med-yassine-ben-salah/ros2-diffdrive-robot-fusion360-cad/robot/previews/front.png

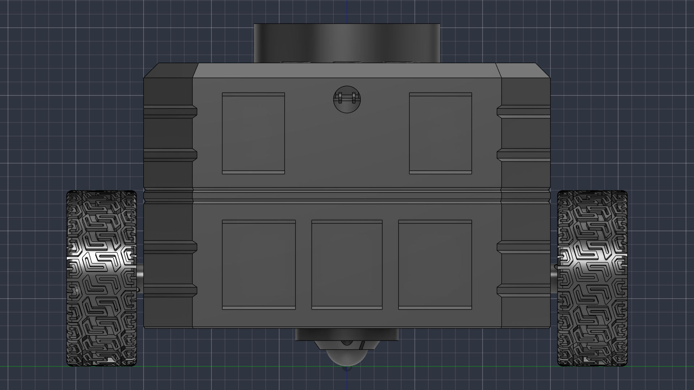
robot/previews/front.png
