med-yassine-ben-salah/ros2-diffdrive-robot-fusion360-cad/robot/previews/left.png

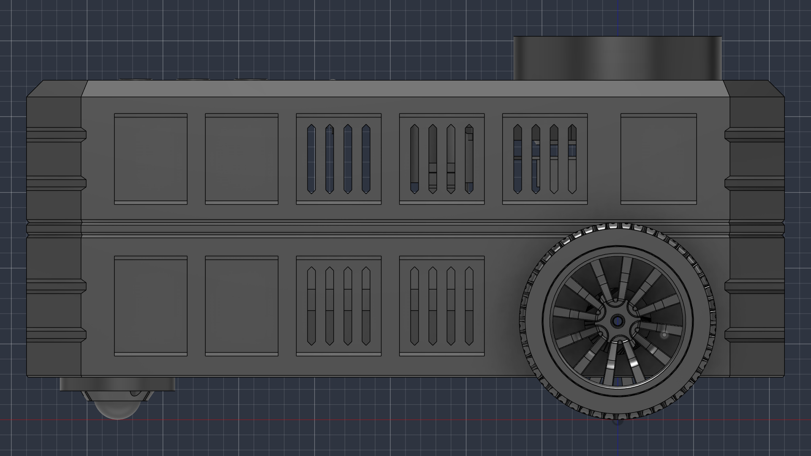
robot/previews/left.png
