med-yassine-ben-salah/ros2-diffdrive-robot-fusion360-cad/robot/previews/rear.png

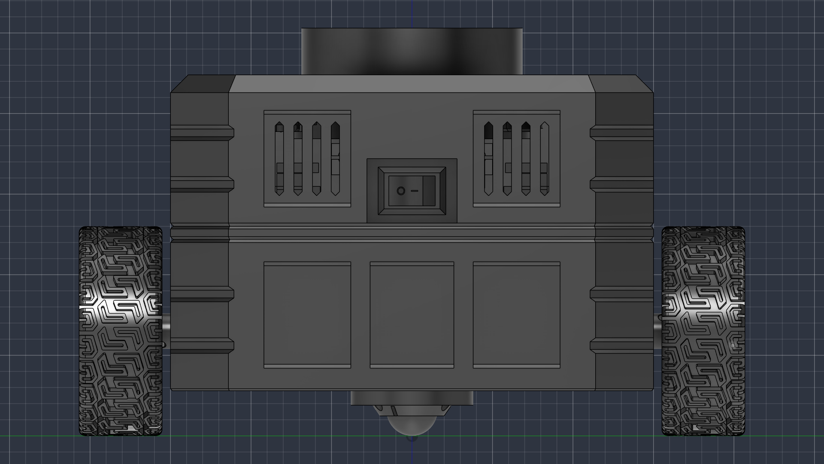
robot/previews/rear.png
