med-yassine-ben-salah/ros2-diffdrive-robot-fusion360-cad/robot/previews/right.png

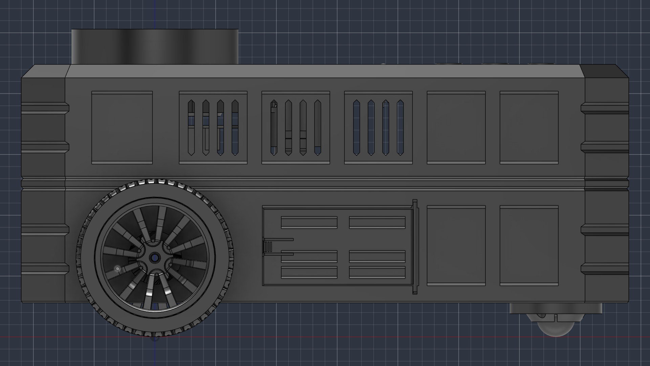
robot/previews/right.png
