med-yassine-ben-salah/ros2-diffdrive-robot-fusion360-cad/models/JGA25-371_with_encoder_ASM.STL

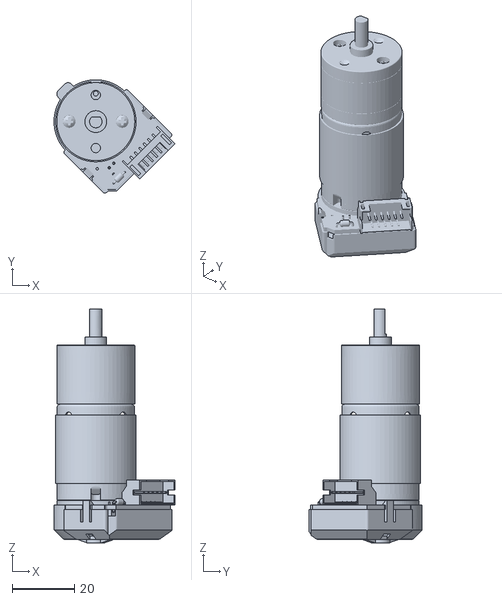
[picture p9: CAD file, 2026-10-25]
models/JGA25-371_with_encoder_ASM.STL
38.8 x 36.3 x 75.0
