med-yassine-ben-salah/ros2-diffdrive-robot-fusion360-cad/robot/export/Upper_Enclosure.step

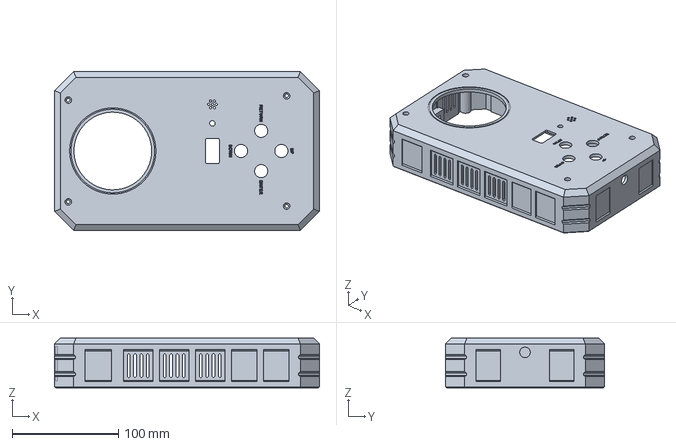
[picture p10: CAD file, 2026-10-25]
robot/export/Upper_Enclosure.step
250.0 x 150.0 x 47.0 mm
