med-yassine-ben-salah/ros2-diffdrive-robot-fusion360-cad/ros2_diffdrive_description/meshes/battery_door.stl

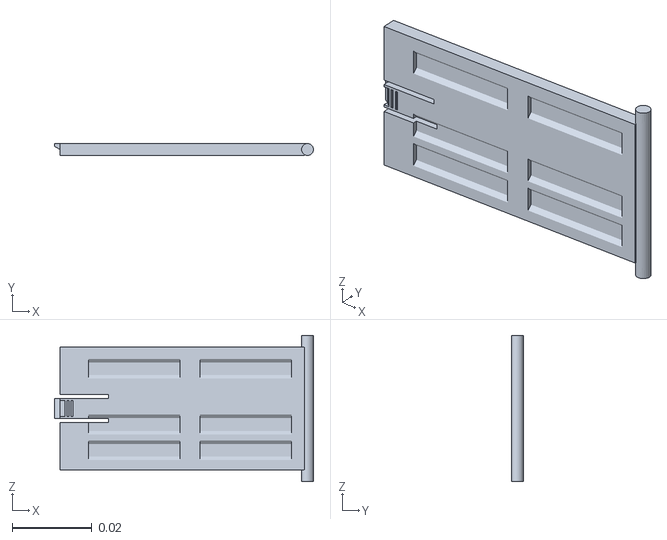
[picture p11: CAD file, 2026-10-25]
ros2_diffdrive_description/meshes/battery_door.stl
0.0651 x 0.003 x 0.0368
