med-yassine-ben-salah/ros2-diffdrive-robot-fusion360-cad/models/lds02rr.step

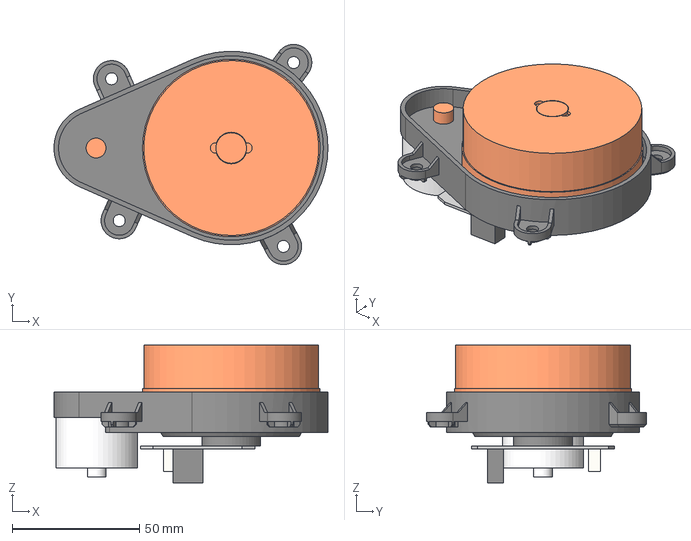
[picture p12: CAD file, 2026-10-25]
models/lds02rr.step
107.6 x 86.5 x 54.1 mm
