med-yassine-ben-salah/ros2-diffdrive-robot-fusion360-cad/ros2_diffdrive_description/meshes/right_wheel.stl

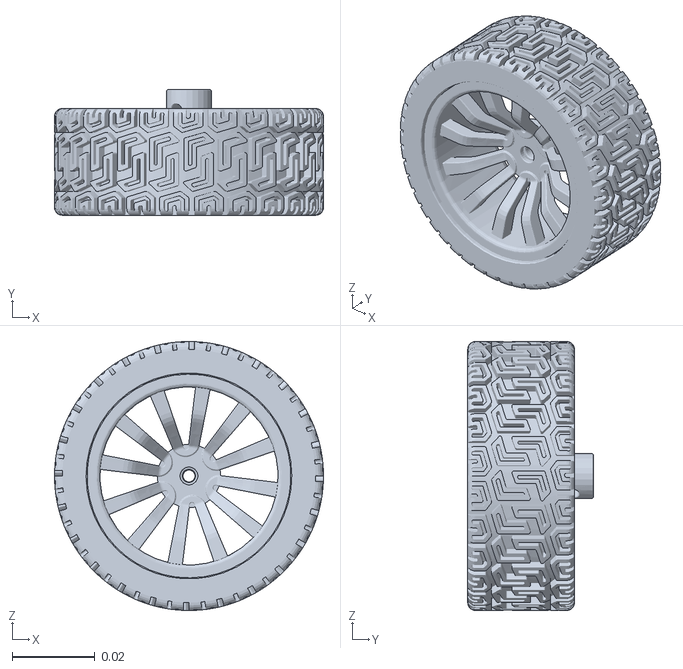
[picture p13: CAD file, 2026-10-25]
ros2_diffdrive_description/meshes/right_wheel.stl
0.0649 x 0.0303 x 0.0649
