med-yassine-ben-salah/ros2-diffdrive-robot-fusion360-cad/models/esp32cam_with_MB.stl

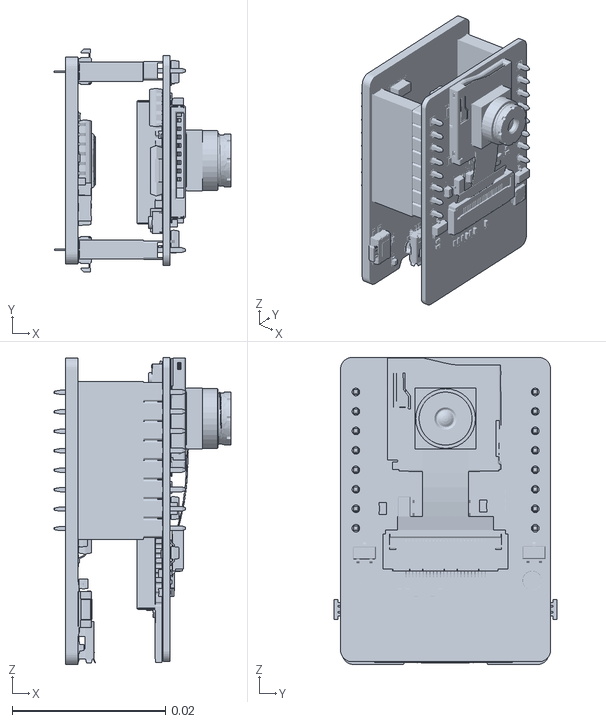
[picture p14: CAD file, 2026-10-25]
models/esp32cam_with_MB.stl
0.023 x 0.0291 x 0.0401
