med-yassine-ben-salah/ros2-diffdrive-robot-fusion360-cad/robot/export/Caster_Socket_Housing.step

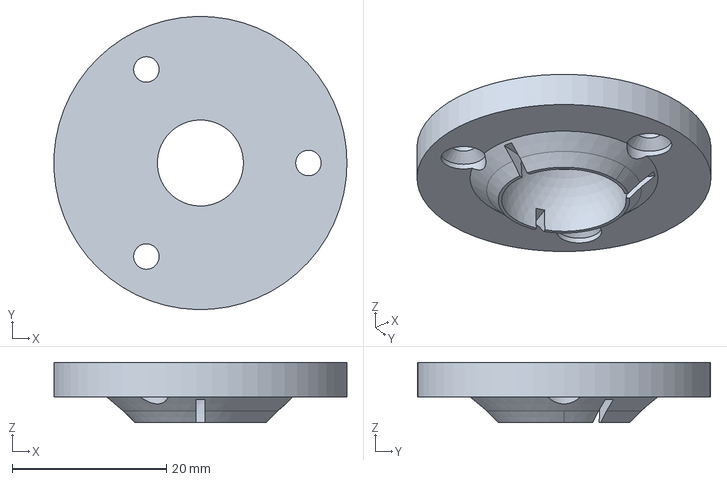
[picture p15: CAD file, 2026-10-25]
robot/export/Caster_Socket_Housing.step
38.0 x 38.0 x 7.80 mm
