med-yassine-ben-salah/ros2-diffdrive-robot-fusion360-cad/ros2_diffdrive_description/meshes/right_motor.stl

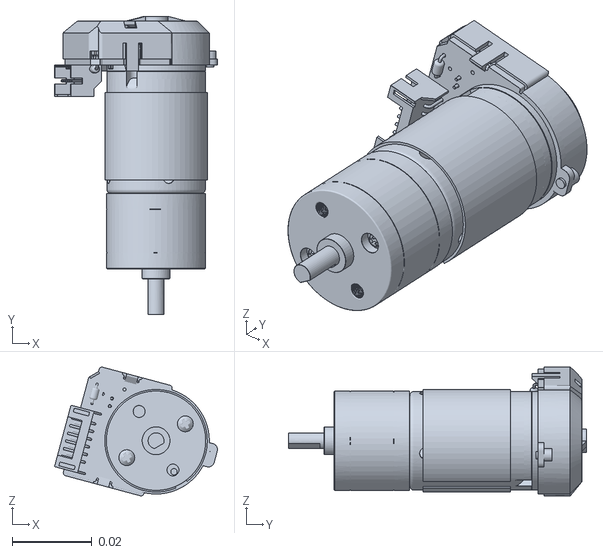
[picture p16: CAD file, 2026-10-25]
ros2_diffdrive_description/meshes/right_motor.stl
0.041 x 0.075 x 0.0324
