med-yassine-ben-salah/ros2-diffdrive-robot-fusion360-cad/models/JGA25-371_Wheel__65mm.STEP

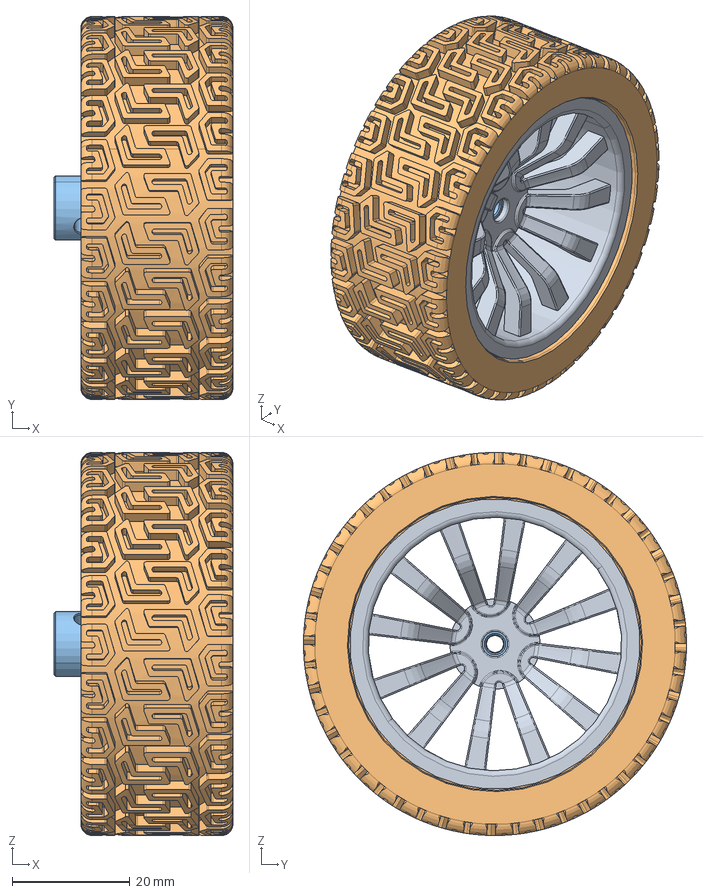
[picture p17: CAD file, 2026-10-25]
models/JGA25-371_Wheel__65mm.STEP
30.3 x 64.9 x 64.9 mm
