med-yassine-ben-salah/ros2-diffdrive-robot-fusion360-cad/robot/export/Battery_Door.step

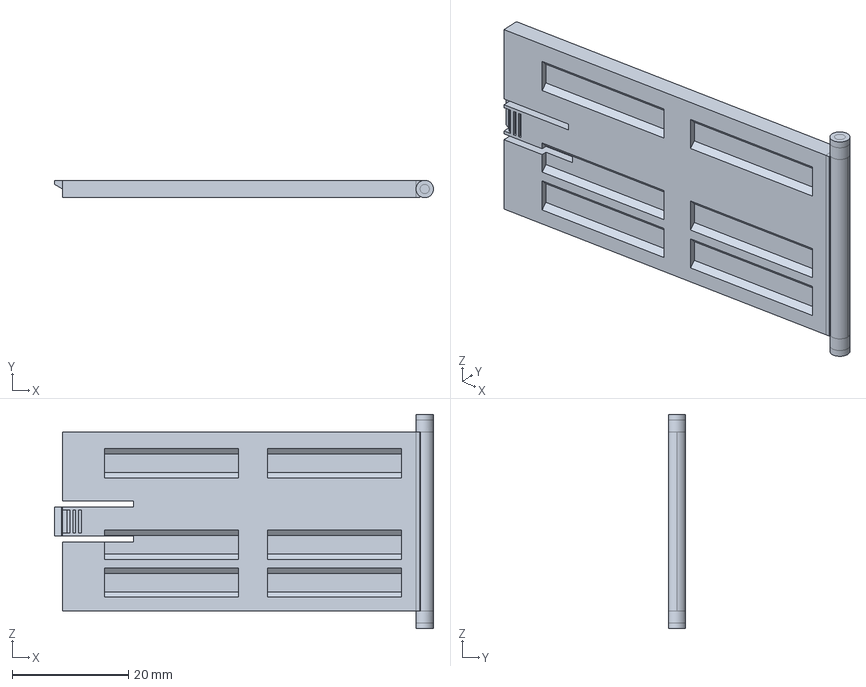
[picture p18: CAD file, 2026-10-25]
robot/export/Battery_Door.step
65.1 x 3.00 x 36.8 mm
