med-yassine-ben-salah/ros2-diffdrive-robot-fusion360-cad/ros2_diffdrive_description/meshes/ui_switches_caps.stl

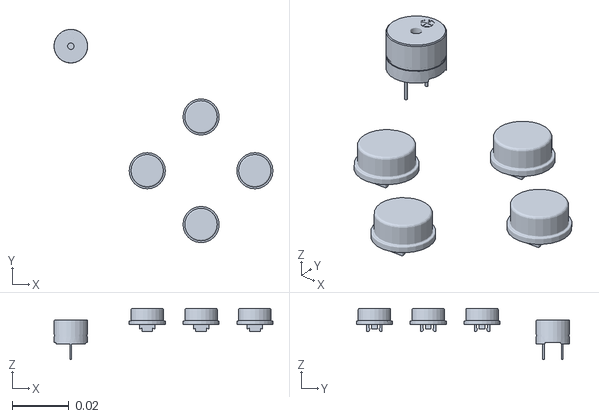
[picture p19: CAD file, 2026-10-25]
ros2_diffdrive_description/meshes/ui_switches_caps.stl
0.0773 x 0.0753 x 0.0181
