med-yassine-ben-salah/ros2-diffdrive-robot-fusion360-cad/models/mpu9250_step.step

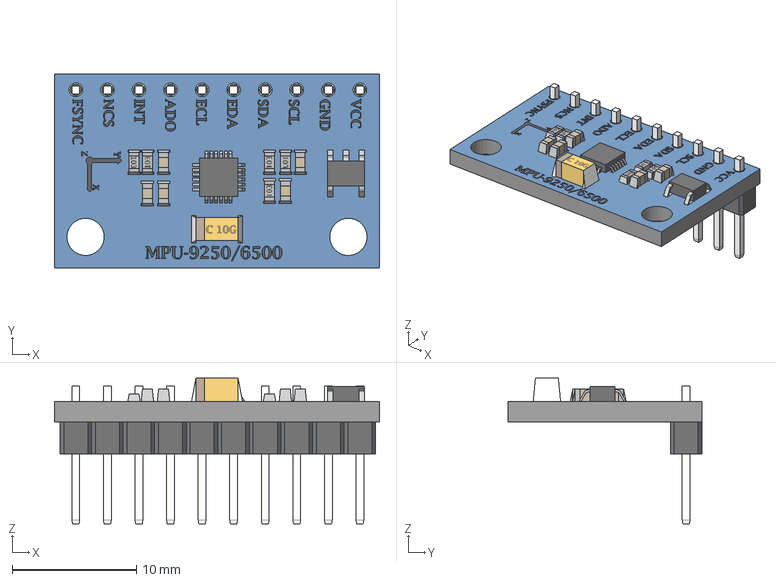
[picture p20: CAD file, 2026-10-25]
models/mpu9250_step.step
26.1 x 15.6 x 11.7 mm
