med-yassine-ben-salah/ros2-diffdrive-robot-fusion360-cad/robot/export/UI_Button_Carrier.step

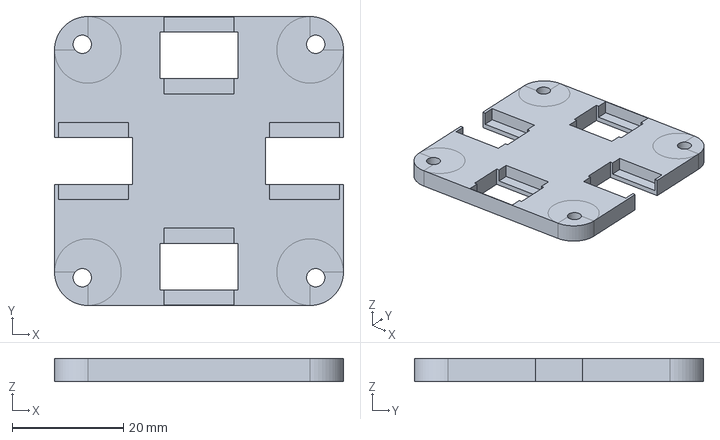
[picture p21: CAD file, 2026-10-25]
robot/export/UI_Button_Carrier.step
52.0 x 52.0 x 4.15 mm
