med-yassine-ben-salah/ros2-diffdrive-robot-fusion360-cad/ros2_diffdrive_description/meshes/ui_oled_switches.stl

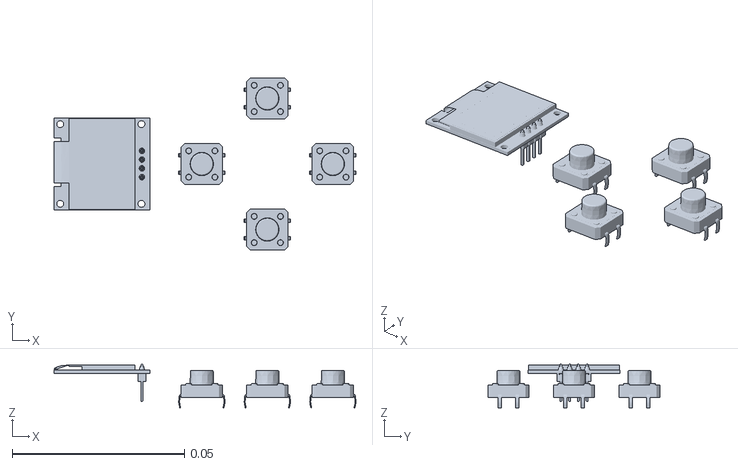
[picture p22: CAD file, 2026-10-25]
ros2_diffdrive_description/meshes/ui_oled_switches.stl
0.0876 x 0.05 x 0.0127
