med-yassine-ben-salah/ros2-diffdrive-robot-fusion360-cad/models/Passive_Buzzer.step

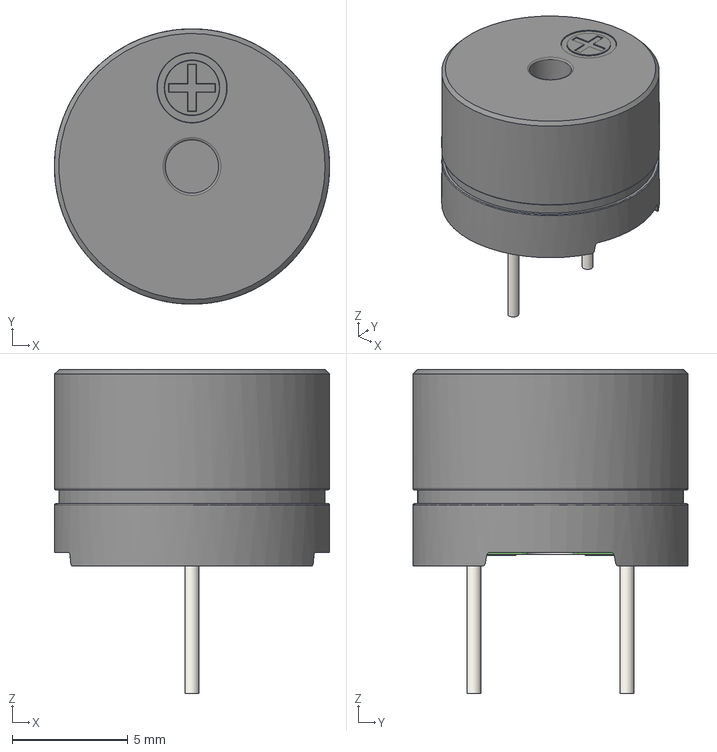
[picture p23: CAD file, 2026-10-25]
models/Passive_Buzzer.step
11.9 x 11.9 x 14.0 mm
