med-yassine-ben-salah/ros2-diffdrive-robot-fusion360-cad/robot/export/Electronics_Deck.step

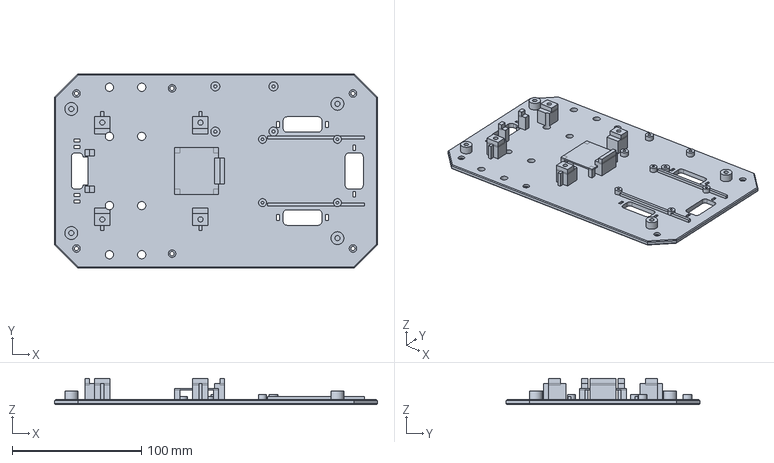
[picture p24: CAD file, 2026-10-25]
robot/export/Electronics_Deck.step
250.0 x 150.0 x 20.4 mm
