med-yassine-ben-salah/ros2-diffdrive-robot-fusion360-cad/models/ON_OFF_Switch.STEP

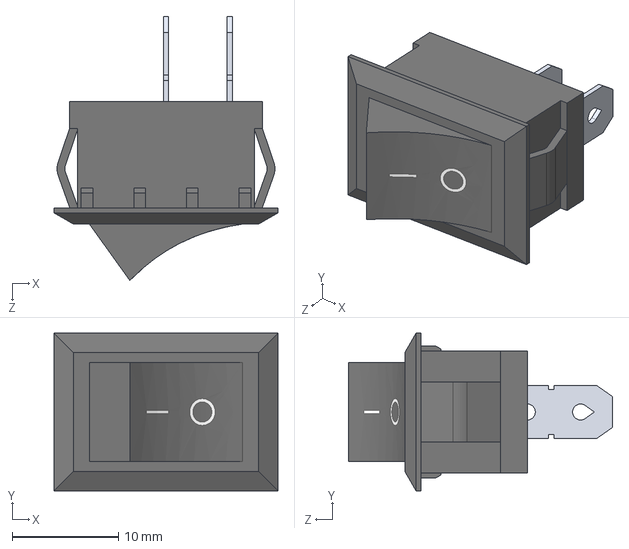
[picture p25: CAD file, 2026-10-25]
models/ON_OFF_Switch.STEP
21.0 x 14.8 x 24.8 mm
