med-yassine-ben-salah/ros2-diffdrive-robot-fusion360-cad/ros2_diffdrive_description/meshes/red_accents.stl

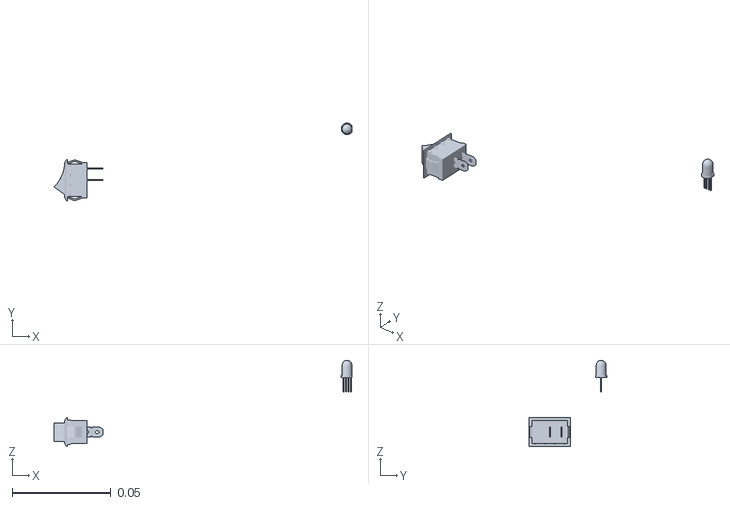
[picture p26: CAD file, 2026-10-25]
ros2_diffdrive_description/meshes/red_accents.stl
0.151 x 0.0395 x 0.0437
