med-yassine-ben-salah/ros2-diffdrive-robot-fusion360-cad/models/5mm_LED_RGB.stp

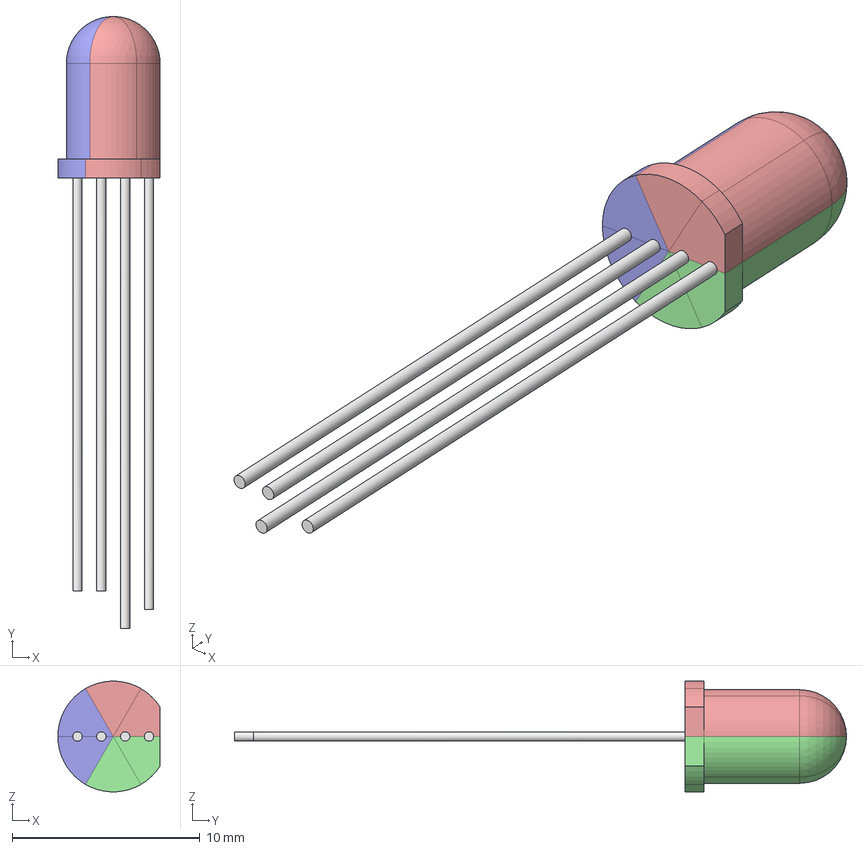
[picture p27: CAD file, 2026-10-25]
models/5mm_LED_RGB.stp
5.45 x 32.6 x 5.89 mm
