med-yassine-ben-salah/ros2-diffdrive-robot-fusion360-cad/robot/export/ESP32_CAM_Bracket.step

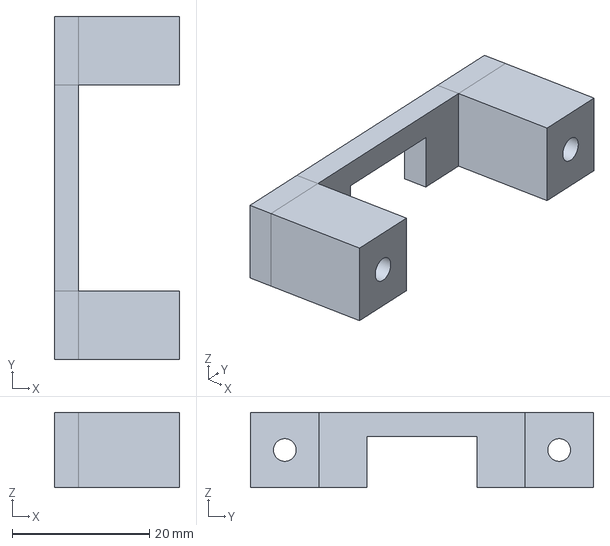
[picture p28: CAD file, 2026-10-25]
robot/export/ESP32_CAM_Bracket.step
18.2 x 50.0 x 11.0 mm
