med-yassine-ben-salah/ros2-diffdrive-robot-fusion360-cad/ros2_diffdrive_description/meshes/lds02rr_lidar.stl

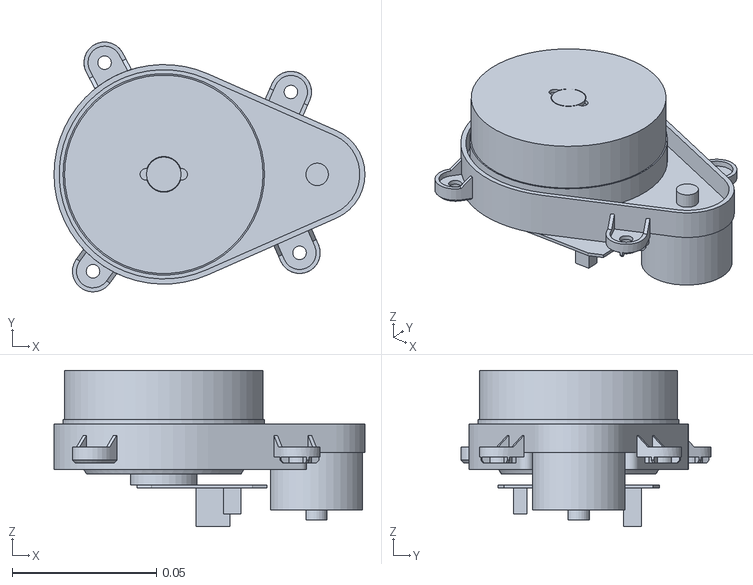
[picture p29: CAD file, 2026-10-25]
ros2_diffdrive_description/meshes/lds02rr_lidar.stl
0.108 x 0.0865 x 0.0541
