med-yassine-ben-salah/ros2-diffdrive-robot-fusion360-cad/models/JGA25-371_Bracket.stl

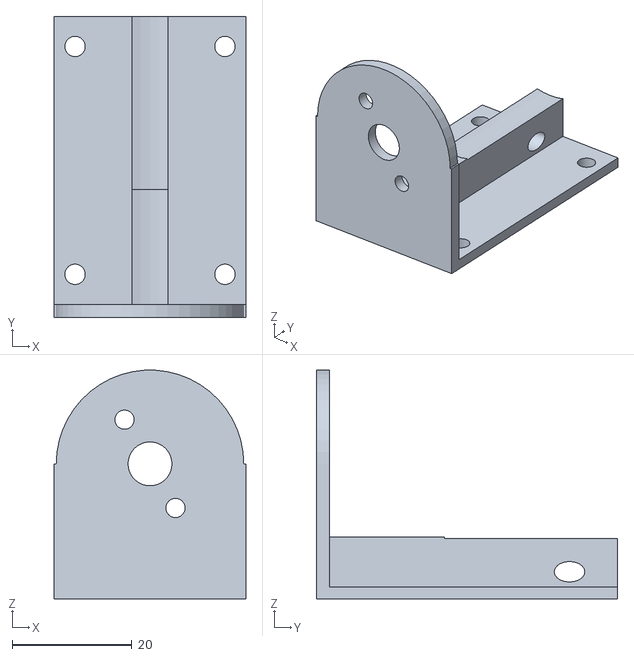
[picture p30: CAD file, 2026-10-25]
models/JGA25-371_Bracket.stl
32.0 x 50.2 x 38.1
