med-yassine-ben-salah/ros2-diffdrive-robot-fusion360-cad/robot/export/Lower_Chassis.step

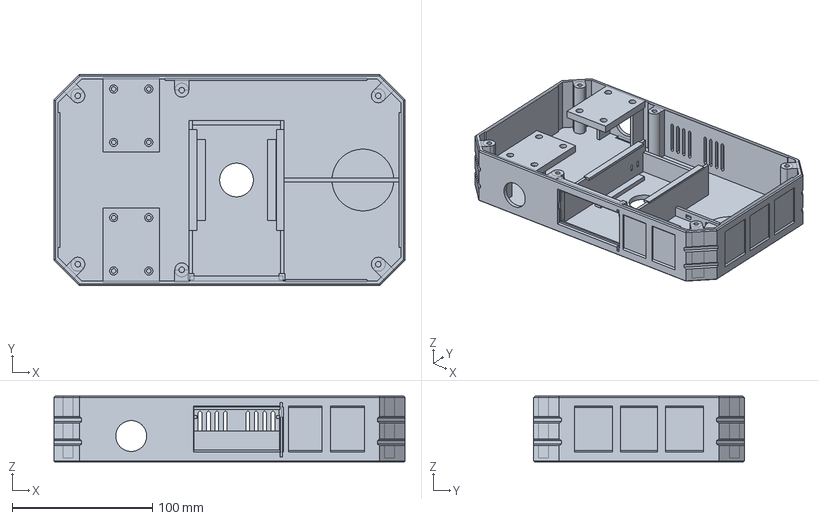
[picture p31: CAD file, 2026-10-25]
robot/export/Lower_Chassis.step
250.0 x 150.0 x 47.0 mm
