med-yassine-ben-salah/ros2-diffdrive-robot-fusion360-cad/ros2_diffdrive_description/meshes/electronics_deck.stl

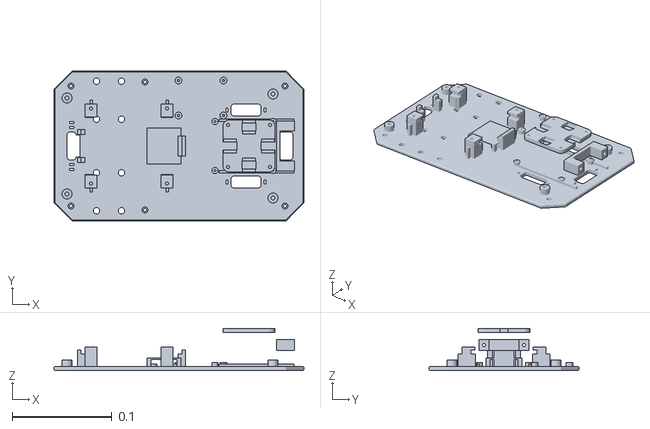
[picture p32: CAD file, 2026-10-25]
ros2_diffdrive_description/meshes/electronics_deck.stl
0.25 x 0.15 x 0.0422
