med-yassine-ben-salah/ros2-diffdrive-robot-fusion360-cad/models/switch_cap_black.stp

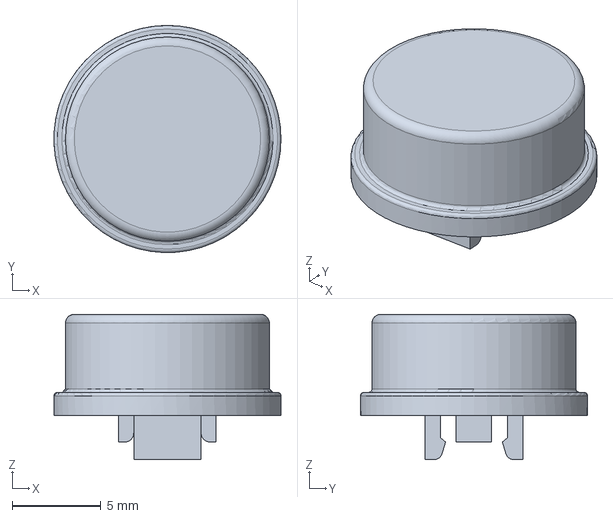
[picture p33: CAD file, 2026-10-25]
models/switch_cap_black.stp
12.8 x 12.8 x 8.20 mm
