med-yassine-ben-salah/ros2-diffdrive-robot-fusion360-cad/ros2_diffdrive_description/meshes/lower_chassis.stl

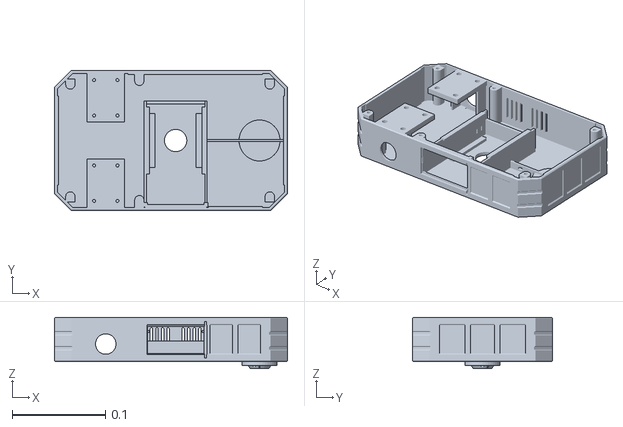
[picture p34: CAD file, 2026-10-25]
ros2_diffdrive_description/meshes/lower_chassis.stl
0.25 x 0.15 x 0.0548
