med-yassine-ben-salah/ros2-diffdrive-robot-fusion360-cad/models/LDS02RR_Plate.stl

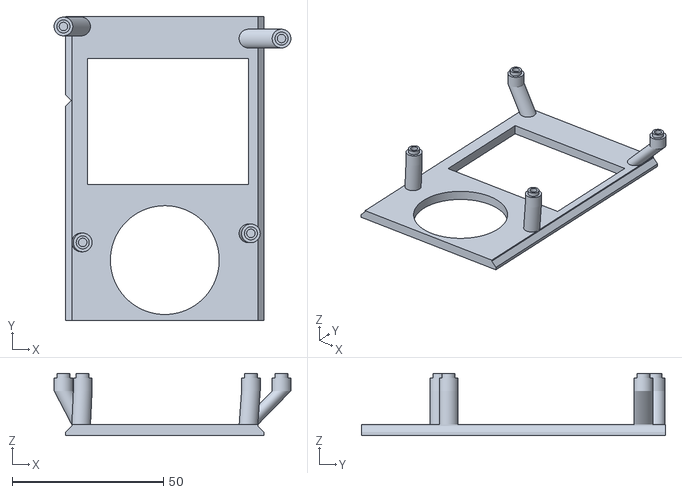
[picture p35: CAD file, 2026-10-25]
models/LDS02RR_Plate.stl
78.4 x 100.6 x 20.6
