med-yassine-ben-salah/ros2-diffdrive-robot-fusion360-cad/robot/export/LiDAR_Pillar_Clamps.step

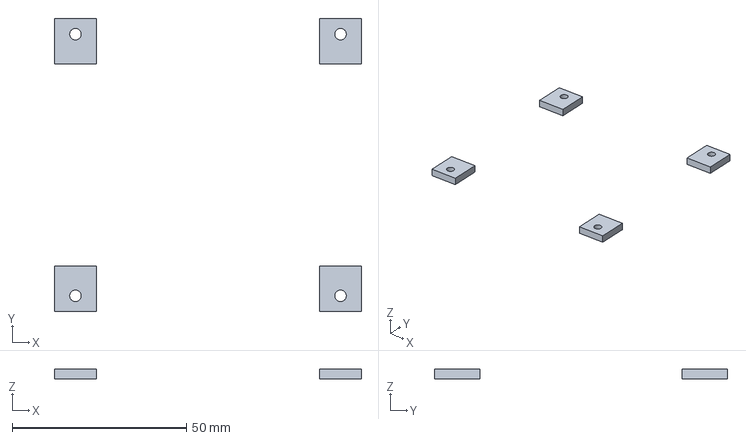
[picture p36: CAD file, 2026-10-25]
robot/export/LiDAR_Pillar_Clamps.step
88.0 x 84.0 x 3.00 mm
