med-yassine-ben-salah/ros2-diffdrive-robot-fusion360-cad/ros2_diffdrive_description/meshes/imu_mpu9250.stl

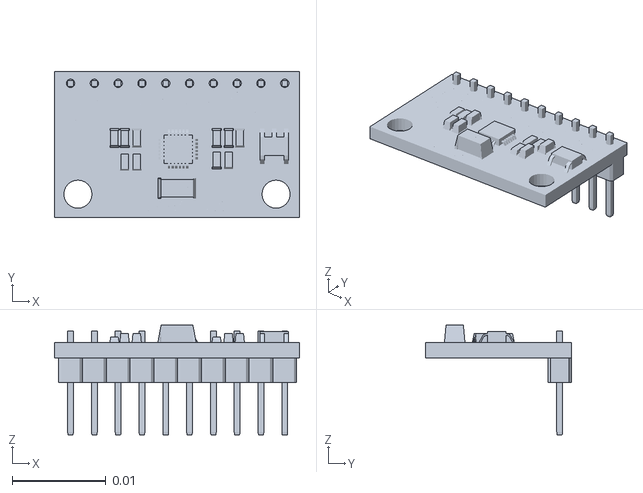
[picture p38: CAD file, 2026-10-25]
ros2_diffdrive_description/meshes/imu_mpu9250.stl
0.0261 x 0.0156 x 0.0117
