med-yassine-ben-salah/ros2-diffdrive-robot-fusion360-cad/ros2_diffdrive_description/meshes/drivetrain_static.stl

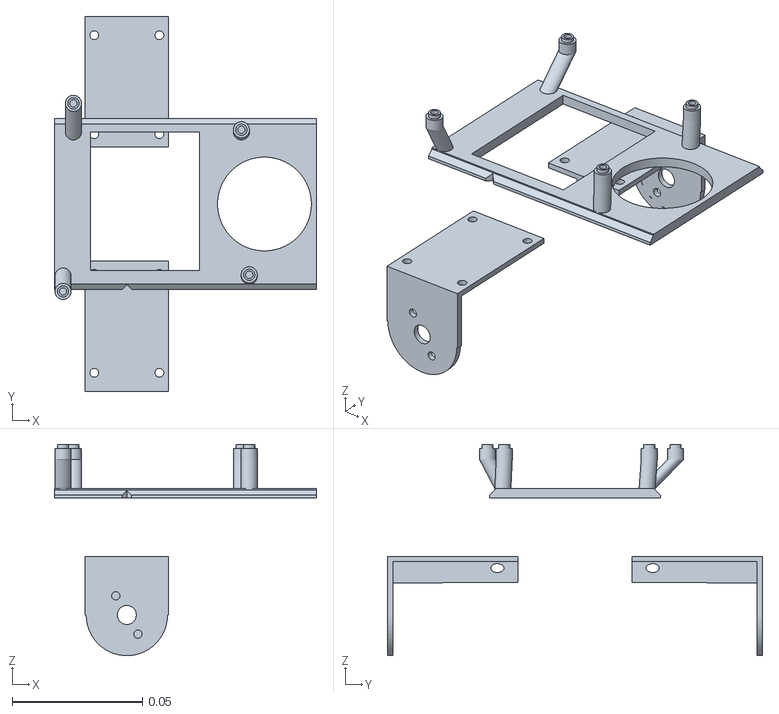
[picture p39: CAD file, 2026-10-25]
ros2_diffdrive_description/meshes/drivetrain_static.stl
0.101 x 0.144 x 0.0811
