med-yassine-ben-salah/ros2-diffdrive-robot-fusion360-cad/robot/export/LiDAR_Pillar_Clamp_Single.stl

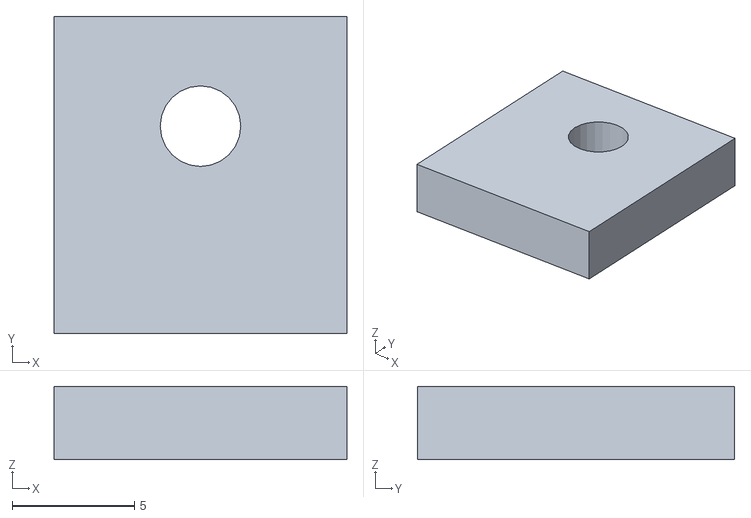
[picture p40: CAD file, 2026-10-25]
robot/export/LiDAR_Pillar_Clamp_Single.stl
12.0 x 13.0 x 3.00
