med-yassine-ben-salah/ros2-diffdrive-robot-fusion360-cad/ros2_diffdrive_description/meshes/caster_ball.stl

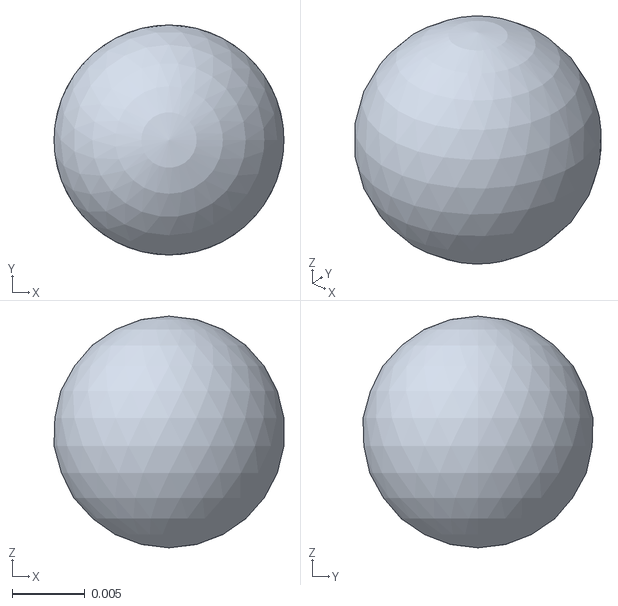
[picture p41: CAD file, 2026-10-25]
ros2_diffdrive_description/meshes/caster_ball.stl
0.0158 x 0.0158 x 0.0159
