med-yassine-ben-salah/ros2-diffdrive-robot-fusion360-cad/ros2_diffdrive_description/meshes/battery_pack.stl

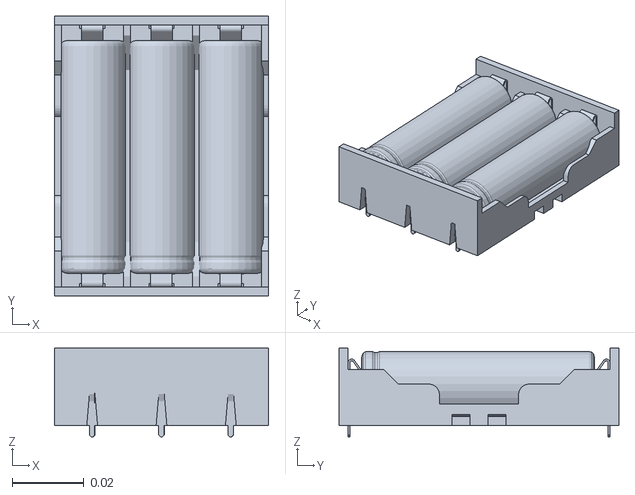
[picture p42: CAD file, 2026-10-25]
ros2_diffdrive_description/meshes/battery_pack.stl
0.0596 x 0.078 x 0.0247
