med-yassine-ben-salah/ros2-diffdrive-robot-fusion360-cad/robot/export/ROS2_DiffDrive_Robot.FCStd

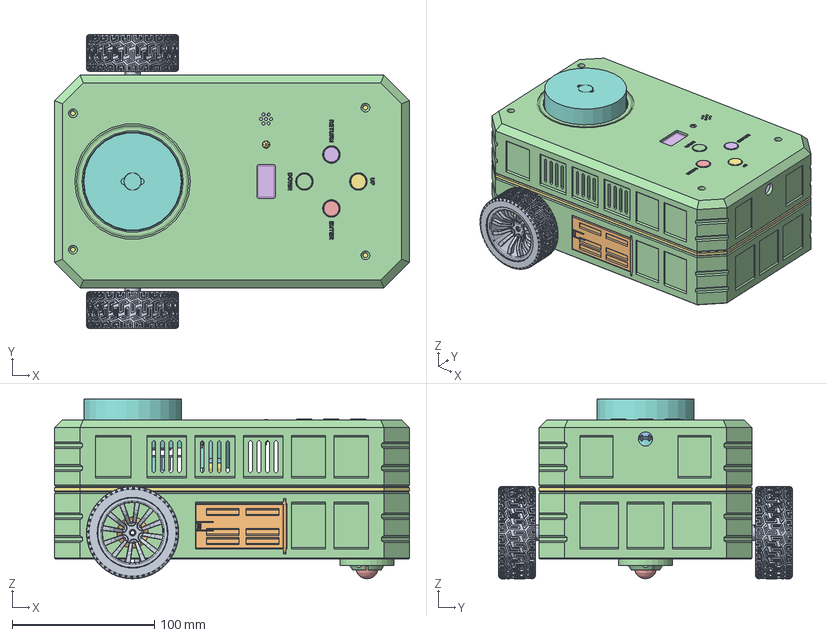
[picture p43: CAD file, 2026-10-25]
robot/export/ROS2_DiffDrive_Robot.FCStd
250.0 x 206.8 x 126.5 mm
Passive Acoustic Buzzer
Snap-Fit Hinged Battery Door
3x18650 Battery Holder
Switch Cap (DOWN)
Switch Cap (ENTER)
Switch Cap (RETURN)
Switch Cap (UP)
Tactile Switch (DOWN)
Tactile Switch (ENTER)
Tactile Switch (RETURN)
Tactile Switch (UP)
Ball Caster Socket Housing
Caster Steel Ball (15.875mm)
ESP32-CAM Mounting Bracket
Middle Electronics Deck
LDS02RR 360 Laser Scanner
Left Drive Wheel (65mm)
Left Motor Bracket
LiDAR Pillar Clamp Caps
Lower Structural Chassis
MPU9250 9-Axis IMU
0.96-inch I2C OLED Display
5mm RGB Status LED
Rear ON/OFF Rocker Switch
Right Drive Wheel (65mm)
Right Motor Bracket
UI Button Switch Carrier
Upper Enclosure Shell
