med-yassine-ben-salah/ros2-diffdrive-robot-fusion360-cad/(list of files, cad)

Other CAD files:
robot/export/ROS2_DiffDrive_Robot_Assembly.step
robot/export/ROS2_DiffDrive_Robot_Assembly_Fusion.step
ros2_diffdrive_description/meshes/esp32_cam.stl
robot/export/Upper_Enclosure_print_oriented.stl
robot/export/Lower_Chassis_print_oriented.stl
robot/export/Caster_Socket_Housing_print_oriented.stl
robot/export/ESP32_CAM_Bracket_print_oriented.stl
ros2_diffdrive_description/meshes/left_wheel.stl
robot/export/Electronics_Deck_print_oriented.stl
ros2_diffdrive_description/meshes/left_motor.stl
robot/export/Battery_Door_print_oriented.stl
robot/export/UI_Button_Carrier_print_oriented.stl
robot/export/LiDAR_Pillar_Clamps_print_oriented.stl
robot/export/Battery_Door.stl
robot/export/Caster_Socket_Housing.stl
robot/export/ESP32_CAM_Bracket.stl
robot/export/Electronics_Deck.stl
robot/export/LiDAR_Pillar_Clamps.stl
robot/export/Lower_Chassis.stl
robot/export/UI_Button_Carrier.stl
robot/export/Upper_Enclosure.stl
