med-yassine-ben-salah/ros2-diffdrive-robot-fusion360-cad/robot/verify_log.txt

Verification Results: 8/8 checks passed.
All geometric criteria satisfied.
