med-yassine-ben-salah/ros2-diffdrive-robot-fusion360-cad/ros2_diffdrive_description/config/my_bot_controllers.yaml

# ros2_control controllers for ros2_diffdrive_robot — shared by Gazebo sim
# and the real robot (my_bot_hardware/MyBotSystem).
controller_manager:
  ros__parameters:
    update_rate: 50  # Hz — matches firmware telemetry rates

    joint_state_broadcaster:
      type: joint_state_broadcaster/JointStateBroadcaster

    diff_drive_controller:
      type: diff_drive_controller/DiffDriveController

diff_drive_controller:
  ros__parameters:
    left_wheel_names: ["left_wheel_joint"]
    right_wheel_names: ["right_wheel_joint"]

    wheel_separation: 0.1810
    wheel_radius: 0.0325

    wheel_separation_multiplier: 1.0
    left_wheel_radius_multiplier: 1.0
    right_wheel_radius_multiplier: 1.0

    publish_rate: 30.0
    odom_frame_id: odom
    base_frame_id: base_footprint
    open_loop: false
    enable_odom_tf: true

    use_stamped_vel: false
    cmd_vel_timeout: 0.5

    pose_covariance_diagonal: [0.001, 0.001, 0.0, 0.0, 0.0, 0.01]
    twist_covariance_diagonal: [0.001, 0.001, 0.0, 0.0, 0.0, 0.01]
