med-yassine-ben-salah/ros2-diffdrive-robot-fusion360-cad/(commit log)

2026-10-25 Initial commit: Port ROS 2 DiffDrive robot CAD & simulation suite to Autodesk Fusion 360 (ported from FreeCAD)
2026-10-25 feat: sync updated parameters, STEP exports (1.8mm LiDAR opening, SD slot, ski-bevel caster)
2026-10-25 fix(enclosure): sync STEPs with clean front profile
2026-10-25 feat(chassis): sync STEPs with 45-deg corner boss geometry
